timurrrr/RaceChronoDiyBleDevice/images/e46_sensor_plug.jpg

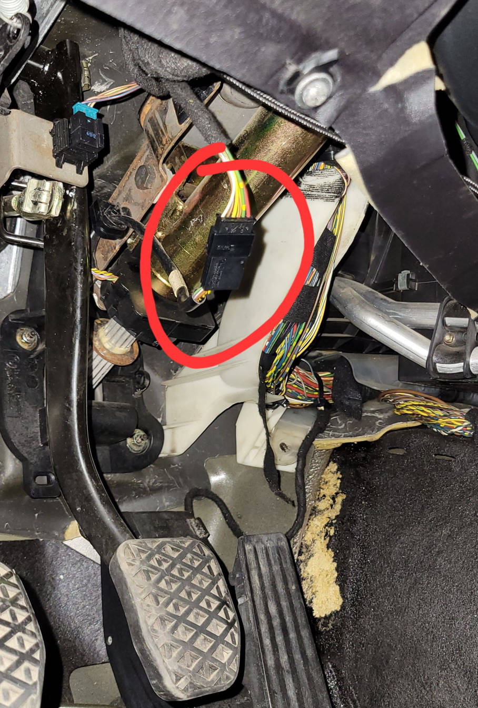
images/e46_sensor_plug.jpg
