timurrrr/RaceChronoDiyBleDevice/(threads)

Thread 2 (2021-03-16):

waiting for data

zn6aura, 2021-03-16:
Trying my hand at this. but I can't seem to get it to work. checked my wiring 10 times over used a multimeter. using the connector behind the headunit with a toyota harness.

racechrono is able to connect with bluetooth to the device but never receives any data. have confirmed can is working with an obdlink.

what would be the best way to troubleshoot this?

thank you for all the information

zn6aura, 2021-03-17:
Okay so I figured it out, I ordered a 3 pack of the mcp2515 following the link in this github.

Two of the chips are labeled 17200TW. Both of those do not work. I tested the third chip when realizing it was labeled 20239RA. And it worked on its first try...

So for anyone else trying this out avoid the chips with 17200TW. They look identical but only one works.

I'm sure there are probably other variations of this as I now see small differences on amazon from different sellers.

timurrrr, 2021-03-17:
Yuck! Sorry this happened. For me, 3/3 worked fine.

As long as at least one works fine, I think $9 is still a good price :D

zn6aura, 2021-03-17:
Yeah, no worries, thanks for the hard work on this project. its working great now

Closed 2021-03-17.

Thread 3 (2021-04-08):

GPS Functionallity

R1Snake, 2021-04-08:
Hi,

works great. Is it possible to add GPS into your project?

timurrrr, 2021-04-09:
Short answer: **yes!**

Long answer: **but...** :)

My project is a re-write of https://github.com/aollin/racechrono-ble-diy-device that already has GPS support.
So it's certainly possible. One option you might consider is just using that project instead of mine.

Personally I didn't find it useful to spend my time on understanding and adding GPS support, as I already own an off-the-shelf external GPS.
On top of that, the main reason I created my own fork was because that build worked super unreliably for me, and I had to question every single part of the project... Turned out to be a power supply issue, as always :))) But when I realized my code is more readable (to me, at least) and more component'ized (and thus allows more flexibility for customization), I figured it would be useful to upload it to GitHub.

Another thing to consider is that Bluetooth has limited bandwidth. If you use one Bluetooth channel to communicate between your DIY gadget and the Android device, the bandwidth will be shared between the CAN reader (that needs all the bandwidth it can get) and the GPS data (that needs roughly the same amount of bandwidth as one extra CAN PID). Although I don't know Bluetooth well enough to confidently say that by using an external GPS you actually get any "extra" bandwidth...

I don't own a GPS-capable board / component I could connect to my build, nor do I have time to work on this anytime soon. At this point I'd rather spend time generalizing the code to make it easier to support other car models. Or making a custom PCB with a smaller footprint.

Having said that, if you (or someone else) can take the code from aollin's project and re-organize it in a way that "plugs in" to my existing code with as little changes to the readability of the CAN/Bluetooth code as possible, and guard that with #ifdef's so that one can still build the project without GPS, I'll be happy to review and merge such a pull request.

Sorry for a long answer, and hopefully it was useful!

Thread 5 (2021-05-16):

Add ability to query OBD PIDs and wrap them into fake CAN PIDs

timurrrr, 2021-05-16:
See https://racechrono.com/forum/discussion/2039/obd2-splitter for a relevant discussion.

At least on Subaru BRZ / Toyota 86 / Scion FR-S, I was unable to find some PIDs (e.g. ambient temperature, fuel level) in the CAN bus broadcasts. As those are "slow" channels anyways, it's fine to just query them via OBD protocol, and send them to RaceChrono, pretending these are CAN messages.

alancyau, 2024-06-09:
In RaceChrono, can you add your OBD reader under the "OBD-II readers" section in addition to the "Other devices" section? That way you can still query standard sensor data such as intake air temp.

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

timurrrr, 2024-06-16:
@alancyau The device would need to implement both the ELM427 (?) protocol and the RaceChrono DIY protocol. That might be a non-trivial amount of work, and I'm not 100% sure that RaceChrono will correctly handle connecting to the same device over two protocols at the same time.

Another option is to make the CAN reader translate "fake" CAN IDs to periodic OBD requests. I've successfully done that in the past, but didn't get around to publishing the code. I need to clean it up a bit first.

Thread 6 (2022-06-22):

Add support for ESP32

jawillis, 2022-06-22:
ESP32 boards are cheap and plentiful.  Hardware projects such as https://github.com/MagnusThome/RejsaCAN-ESP32 would be a ready solution without need for a power supply and external CAN transceiver.
I'm willing to put development effort into this, if you can provide some direction towards a method that would be acceptable for a PR.

timurrrr, 2022-06-29:
Hello jawillis@, and thanks for your recent donation!

In fact Magnus sent me a couple of his boards for testing, so this was something I was already considering.
Unfortunately, I also caught COVID recently, which shifted all my plans.
I will certainly appreciate it if you can help! :)

Take a look at the current source code for this project
https://github.com/timurrrr/RaceChronoDiyBleDevice/blob/master/RaceChronoDiyBleDevice.ino
and how it depends on <RaceChrono.h> provided in this library:
https://github.com/timurrrr/arduino-RaceChrono/blob/master/src/RaceChrono.h

It would be ideal to try to update the `arduino-RaceChrono` library in such a way that the "interface" between the library and the project (`RaceChronoDiyBleDevice.ino`) remains unchanged.
Depending on whether you're compiling it for nRF528** or ESP32 it could automatically pick the right implementation using something like `#if defined(ARDUINO_ARCH_ESP32)`. I presume there should be a similar macro defined by some of the nRF headers, try `NRF52832_XXAA` and `NRF52840_XXAA`?
It might be hard/impossible to preserve the exact "interface" though, so if the underlying BLE libraries for nRF and ESP are very incompatible, we can try to update the "interface" in a way that works with both of them.

So maybe for your initial PR, just rewrite whatever is needed in the .cpp files, while trying to keep the changes in `RaceChrono.h` to the minimum. Then I can take a look at the changes and see how best to organize the code to build the right variant automatically.

Thanks for your help!

jawillis, 2022-06-29:
You're very welcome.  Thanks for putting a great project out there for the community!  I've already built 2 of these for myself and a friend for our BMW e46 track cars.  It was great to be able to just assemble, upload the code and have it work.  I hope you have a speedy recovery from COVID!

It looks like `#if defined(ARDUINO_ARCH_NRF52)` is the macro we're looking for.

I've been looking more into the `arduino-RaceChrono` code, and I agree that almost all the work will be concentrated there.  I've been thinking of a something basically like [this](https://github.com/MagnusThome/Racechrono-LIVE-telemetry-data-export/blob/main/main/rcmonitor.ino)

There are some other features I would like to include eventually to this project overall, such as multiple canbus interfaces and analog inputs, but I shouldn't get ahead of myself here...

timurrrr, 2022-07-01:
Oh nice, the `rcmonitor.ino` file is a good example of how to write code to "automatically" pick either `<bluefruit.h>` or `<NimBLEDevice.h>` depending on availability.

Cool story about the E46, I'm very happy to hear it was useful for you and your friend :)
Feel free to also send a PR to add a wiki page with common CAN IDs and RaceChrono equations.
Did you figure out how to log the brake pressure data? I think I heard E46's don't have those sensors.
Or is _that_ why you want to add analog inputs?

jawillis, 2022-07-01:
The e46 does have brake pressure sensors, but those messages are only available on a different bus between the abs and engine computers.  That actually why I'd like to add another can interface.  Some people plumb in extra brake pressure sensors to log that data, but it seems more practical to just add another mcp2515 to the project.  The analog inputs would be for engine oil pressure, trans/diff temps, etc.
I am working on the wiki page for the CAN ID's and equations.  I have already created an e46.h file.

jawillis, 2022-09-03:
I think this can be closed now that ESP32 support has been added.

Closed 2022-09-03.

Thread 8 (2022-08-06):

Add Support for Megasquirt Ecu

TonyEvo, 2022-08-06:
Hi Timurr, I also wrote to you on the race chrono forum and you were very kind to answer me. As I mentioned, I would like to create my own project(not really mine, but for my ecu) to be able to read the Can Bus signals from my ECU (megasquirt 2, a widely used reprogrammable Race Ecu) to be able to read the values   also on race chrono, I wanted to know your opinion on the feasibility, in this screen shot there are the info on the Can signals.
[https://preview.redd.it/rx6mbh08nla81.png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](url)
P.S. I have already created a similar project with arduino (thanks to a friend who knows about code) and a mcp2515 and it seems to work, but it is a bit cumbersome and not very fast. However, since I also bought an nRF52832 and I have another MCP, I could try to create this project too and see how it behaves.

timurrrr, 2022-08-11:
Hi Tony!
Since I don't have that ECU on my cars, I won't be able to effectively add support for it myself.

However, I'll happily accept a Pull Request if you send me one.
You can follow PR https://github.com/timurrrr/RaceChronoDiyBleDevice/pull/7 as an example.

Thread 9 (2022-09-01):

read rate constraints

Andrew-Merrow, 2022-09-01:
https://github.com/timurrrr/RaceChronoDiyBleDevice/blob/93c31e1ae916a2890c355cbe482acd9c0ce50642/configs/ft86_gen2.h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

Are there any constraints besides file size which are causing you to restrict read rate?  I am interested in capturing 100Hz+ signals at their native speed.

timurrrr, 2022-09-02:
Bluetooth Low Energy (BLE) has limited maximum bandwidth.
If you try to send more than BLE allows, some information will be dropped, one way or another.
By dividing the rate programmatically, you get more control over how it gets dropped.

Part of the inefficiency of the current implementation is that for messages we try to communicate via BLE, we send send all the bytes of the message -- even if only 1 bit is actually needed by RaceChrono.
Furthermore, sending each BLE packet requires a non-trivial amount of overhead due to packet header (length, checksums, etc.).

It should be possible to improve the effective data rate by squeezing the same amount of useful information into fewer bytes and/or fewer packets.
For example,
1) truncating the bytes after the "useful" bytes in each CAN message (allows retaining all CAN IDs and equations in RaceChrono)
2) dropping all non-important bits from each CAN message, and only sending the important ones (will require changing some of the equations in RaceChrono, might be worth reporting them under different CAN IDs to avoid confusion)
3) re-packaging data from multiple CAN messages into one extra-efficient "mega message"

1 or 2 should be easy to do.

GR86 unfortunately requires 3 high-speed channels (3 bytes from 64, 2 bytes from 312, 3 bytes from 313), and 312 is only used for the steering angle – isn't very efficient.
It should be possible to re-package the data (see (3) above) into 2 or even 1 packet sent at a higher rate.

Another possibility is to change the transport from BLE to Wi-Fi altogether, but that would require changes in RaceChrono DIY protocol.

That being said, if you just want to monitor the CAN bus with an Arduino (i.e. no RaceChrono) and/or your laptop, the `arduino-CAN` library should be able to handle most/all CAN messages.

Thread 10 (2022-09-17):

Test failed on 2022 brz zd8

luzaowei88, 2022-09-17:
Test failed on my 2022 brz
I followed the tutorial exactly, but still failed to get data on my 2022 brz.
"Waiting to fetch data" shows Racechrono both on ios and Android
[https://photos.app.goo.gl/C3WRRwmvh5xWLbzg9](url)

Does this project not support the 2022 brz zd8 ?
thanks.

timurrrr, 2022-09-19:
Do you get any data at all? Try this program instead:
https://github.com/timurrrr/arduino-CAN/tree/master/examples/CanBusMonitor
and watch Serial Monitor in Arduino IDE.

If you got multiple MCP breakout boards, try another one.
Did you do the quartz mod? If not, you need to update the code to match the frequency of the quartz you actually have.

Advice based on my experience: don't use those screw terminals, you're millimeters away from causing a short circuit in the CAN network of your car. Ask me how I know 🥲 To avoid repeating the mistake, I soldered a JST connector to the board and the CAN adapter.

timurrrr, 2022-09-19:
I haven't personally tried on a 2022 BRZ but I'm 99% sure that it works. 2022 BRZ and 2022 GR86 are basically the same car.

luzaowei88, 2022-09-19:
hi, timurrrr, thanks for ur replay.
I've:
1. Changed origin 8hz quartz to 16hz on MCP2515.
2. Fixed error MCP2515.cpp: In member function 'boolean MCP2515Class::setFilterRegisters(uint16_t, uint16_t, uint16_t, uint16_t, uint16_t, uint16_t, uint16_t, uint16_t, bool)' ,etc.
3.  Conected J1 on the MCP2515 to provide a 120 ohm resistor.

Now i am preparing my macbook to try ur canbus monitor and ordered an JST connector , will let you know later.

Thread 11 (2022-11-14):

Throttle position went up while braking for Gen 2 BRZ

yzhan1, 2022-11-14:
Hi Timur,

Thanks for putting the database together. I was able to use it for my THW track day and it was super helpful!

One issue I found is sometimes when I brake, the throttle position captured would go up too even though I didn't touch the throttle at all. You can see the video [here](https://youtu.be/A40YHt9TG8o?t=29) when I entered T3. I didn't downshift so there shouldn't be throttle movements at all.

I'm new to CAN bus data logging so I'm not sure what could've caused this. Is this because of a bad equation/PID/RaceChrono/CAN adapter? I used a CAN adapter I purchased online which is specifically designed for Gen 2 BRZ and GR86.

Any help is appreciated!

timurrrr, 2022-11-14:
Hi Yaoming!
The underlying CAN bus data protocol makes it pretty much impossible for any wiring issue to cause wrong data to be received — it has checksums and stuff. It would be a lot more likely to just _stop receiving data_ than to get wrong data.

In your video, I see the throttle pedal data going smoothly from 0% to 15% slightly after you start braking, and smoothly going back to 0% pretty much in sync with how you release the brakes.

My hunch is that you did in fact touch the throttle pedal without realizing it.
The throttle pedal in these cars is pretty light, so it's hard to notice when it's only lightly pressed, and 15% requires very little force.
I guess at this point we don't have good data to prove that this is what actually happened (or to prove that it definitely didn't happen)...

If you see this happening often, you might consider using a foot cam to see what's going on down there.

timurrrr, 2022-11-14:
Also minor unrelated tip: since you already have the steering angle gauge and you see the steering wheel in your video, you should be able to sync the data to the video more precise.
In your video, the data is a bit behind the video.

yzhan1, 2022-11-14:
Hmmm, interesting... I checked the videos from some other laps and they don't seem to have this issue sometimes, so actually could be a user error :) Thanks for pointing this out!

Re: video sync - I tried using RaceChrono to sync the GoPro videos for me but unfortunately, my phone just doesn't have enough storage space needed so I had to manually sync in iMovie which is much more error-prone :(

Closed 2022-11-14.

Thread 12 (2023-01-24):

Hope to make one for AIM

FF-Kenny, 2023-01-24:
Can I entrust you to redefine the CAN BUS protocol of 20022 BRZ?
It is used on the display of AIM and pay you. This problem is bothering me

timurrrr, 2023-01-26:
This project is for RaceChrono, not AIM.

[For my own records, we've chatted offline and I helped Kenny find the info about AIM setup for gen2]

Closed 2023-01-26.

Thread 13 (2023-10-03):

Works with esp32s3

RayDutchman, 2023-10-03:
works with esp32s3. I excluded the CAN.h library but used the TWAI library of the esp32 instead, because it already has a built in CAN controller, no reliability issue at all. And the transceiver I use is SN65HVD230 as recommended by Expressif. This combination is very economic, I just got all the hardware for less than 50 rmb which is about 7 USD. I also added codes to measure one analog reading(the oil pressure) and feed it to the CAN-bus and racechrono with a fake CAN id. Much apperiaction to your work!

RayDutchman, 2023-10-03:
I'm curious about why you wanted to devide the can-data received, because I changed all the deviding number to 1 and there's no apparent issue. Also I wants to figure out what's delay of the transmission process, the loop in my codes takes less than 1ms but apparently the delay is more than that.

timurrrr, 2023-10-05:
I don't remember, I was dealing with some performance/stability issues early in the development of this project. It eventually turned out to be a hardware issue (unstable voltage on the power to the MCP chip). It's very much possible that it's no longer needed.

vilkaslabaipilkas, 2025-01-13:
Hi @RayDutchman, how could I contact you?

Thread 14 (2024-05-18):

Invalid throttle calculation for NC Miata

mlyszczek, 2024-05-18:
Hello,

I am using your database for NC Miata - everything works great thank you for that! But calculation for my throttle position was invalid.

For me valid formula is (CAN ID 0x201). It works perfectly for my throttle pedal position from 0 to 100%

`bytestouint(raw, 6, 1) / 2.0`

Maybe there was some changing between vehicles? I have NCFL1 with 2.0 engine. I also have ecutek racerom, but I doubt they changed this.

If current formula works for people then maybe it would be worth to add a note about this?

timurrrr, 2024-06-16:
Thanks for reporting! Unfortunately, I don't have any way to test. @jeby what do you think?

Thread 15 (2024-07-04):

CAN bus info for ND3

el-hoshino, 2024-07-04:
Unfortunately MX-5 ND3 has changed the electronic platform, and all settings for old NDs doesn't work any more.

Is there anyone who is interesting in reverse-engineering CAN bus info for ND3?

timurrrr, 2024-07-04:
Thanks for sharing! That's a surprise for sure.

Will definitely be happy to get a PR from someone adding the data mapping for ND3s. I know someone with an ND3, but I'm currently busy with other projects, so this is not near the top of my list.

Thread 18 (2025-09-23):

ASC(Active Sound Control) connector and pinout

honnesh, 2025-09-23:
I am inspired by people like you to tinker with my car by sniffing the CAN bus data. I imagine you tap into the CAN bus that connects to the Active Sound Control systems could you please point me to the connector for that and the pins on that connector for CAN bus, power and ground.

Closed 2025-09-24.
