timurrrr/RaceChronoDiyBleDevice/(commit log)

2020-08-28 Add instructions on how to assemble a device
2020-08-28 Add info on wiring for FT86
2020-08-28 Add an image of how it looks assembled in the glovebox
2020-09-04 Update the docs to recommend powering the MCP from regulated 3.3V
    Turns out the USB power from the board is unregulated, and causes stability
    issues with the MCP when actively using Bluetooth.
    More details:
    https://racechrono.com/forum/discussion/comment/10996/#Comment_10996
    [RaceChronoDiyBleDevice.ino]
2020-09-04 Minor updates, bump SPI back to 10 MHz
2020-09-09 Add more data on PID 0x141
2020-09-11 Count the number of CAN bus failures, report them in 0x777
    [RaceChronoDiyBleDevice.ino]
2020-09-16 A couple of updates the the PID database
    Thanks "map" from ft86club forum!
2021-01-30 Extract the device name into a constant at the top of the file to make it easier to change
2021-06-14 Add a couple of tables with recommended PIDs to the top of the FT86 page
2021-06-16 Change "Z rate of rotation" to "Yaw rate"
2021-06-28 Add some information about the CAN bus of ND Miatas
2021-07-05 Replace "PID" with "CAN ID" in docs
2021-07-12 Fix scale for "Brake pressure"
2021-07-25 Tweak the equation for the "Brake pedal position (%)" data channel for ND2 Miatas
2022-01-10 Fixed the equation for the ND Miata brake pedal channel
2022-06-05 Introduce config.h and provide separate configs for gen1 and gen2 86's
    Remove MCP filtering for now, I don't think it's needed anymore.
2022-07-06 Invert the recommended equation for steering angle so that it matches what RaceChrono expects
2022-07-26 Add an image showing which harness to use to get CAN bus data in a BMW E46 3-series
    Photo provided by jawillis, thanks!
2022-08-14 Make the baud rate of the CAN bus car-specific.
2022-08-16 Minor change to allow this code to compile with ESP32 version of arduino-RaceChrono
    In case you haven't seen, please update your checkout of arduino-RaceChrono to
    make sure you have the latest goodies available, such as basic ESP32 support.
2023-02-16 Add a "donate" button at the bottom
2023-02-16 Add a "donate" button at the end, remove obsolete boilerplate
